Shreyansh-53/EVSE-CP-analyzer/README.md

# EVSE-CP-analyzer
AC EVSE Control Pilot (CP) Signal Analyzer for EV charging using LTspice, analog signal conditioning, and STM32G474 firmware for PWM decoding and state classification.
