Shreyansh-53/EVSE-CP-analyzer/docs/PLC Report.pdf

# STM32 EVSE CP Signal Analyzer

## Signal Flow in CP

In standard AC EV charging, the EVSE and the EV communicate entirely through the Control Pilot (CP) signal, governed by the IEC 61851-1 protocol. The CP signal carries two independent pieces of information:

Voltage Level
+12V / +9V / +6V / +3V

Tells the EVSE: is the EV present, connected, or charging?

PWM Duty Cycle

### 1 kHz · 10% to 96%

Tells the EV: what is the maximum current you may draw?

## Signal Conditioning Circuit

The signal conditioning circuit scales the ±12V CP signal to a 0–3.3V range and provides galvanic isolation (PC817 optocoupler, 5000V rated) between the EVSE mains-referenced PE ground and the MCU signal ground.

1) Duty of Original Signal decides the current limit.
2) Altitude of PWM of Original Signal decides the State of Charging.

## LTSpice Simulation of signal conditioning circuit-

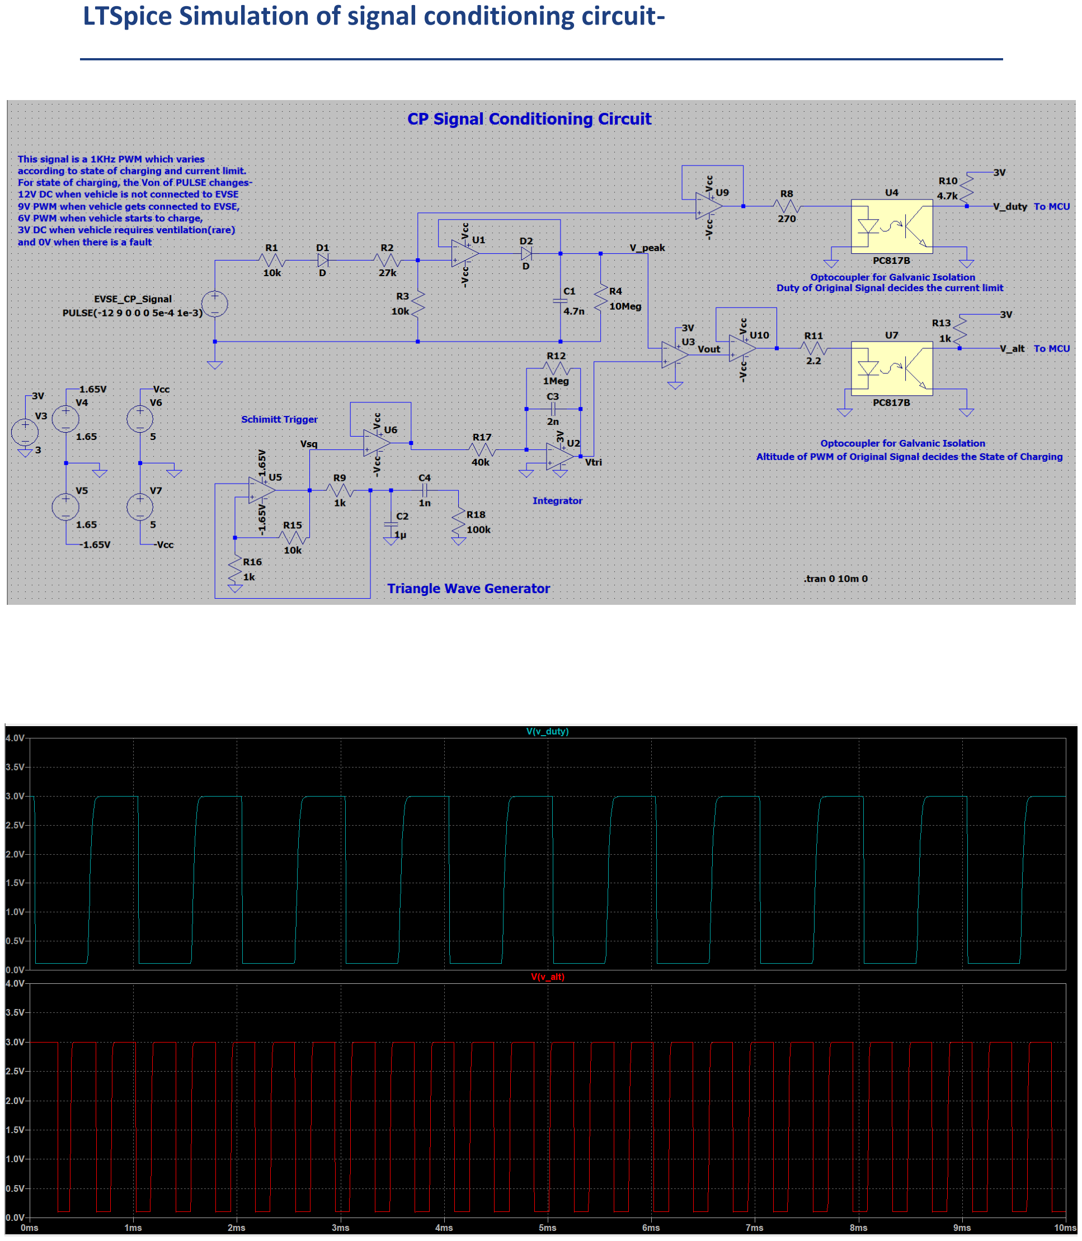
[picture p1: page 2]

## EV Connection States & Coded Logic

State | Description | PWM on PA0? | ADC Threshold (PA1)
A | Standby — No EV connected | No (DC only) | ADC ≥ 2600 mV
B | EV Connected — Ready to charge | Yes (1 kHz) | ADC ≥ 1837 mV
C | Charging — EV drawing current | Yes (1 kHz) | 400 mV ≤ ADC < 1837 mV
D | Charging + Ventilation required | No (DC only) | 400 mV ≤ ADC < 2600 mV
E | Fault — CP shorted or open circuit | No | ADC < 400 mV (no prior PWM)
F | EVSE Internal Fault | No | ADC < 400 mV (PWM was seen before)

## Current Limit Calculation (IEC 61851-1)

Duty Cycle | Max Current | Formula
8% to 85% | 4.8 A to 51.0 A | I = duty × 0.6
85% to 97% | 52.5 A to 82.5 A | I = (duty − 64) × 2.5
< 8% or > 97% | 0 A (Fault zone) | Current = 0 (system stops)
Examples: 25% → 25×0.6 = 15.0A | 50% → 50×0.6 = 30.0A | 90% → (90−64)×2.5 = 65.0A

## Conditioned Signal Waveforms (At STM32 Input)

These waveforms are supplied directly by the function generator to PA0 and PA1, bypassing the conditioning circuit, to verify the firmware before connecting to a real EVSE.

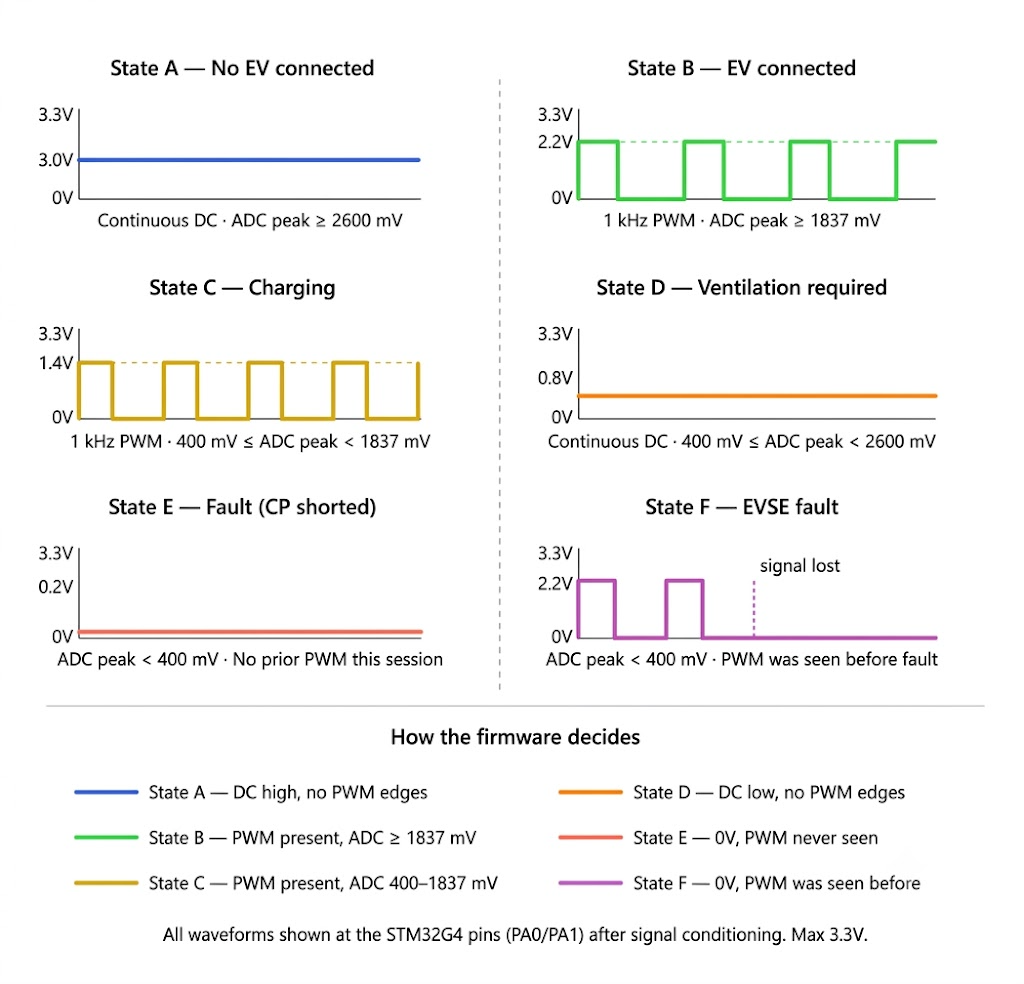
[picture p2: figure]
