Shreyansh-53/EVSE-CP-analyzer/docs/Screenshot 2026-07-09 130957.png

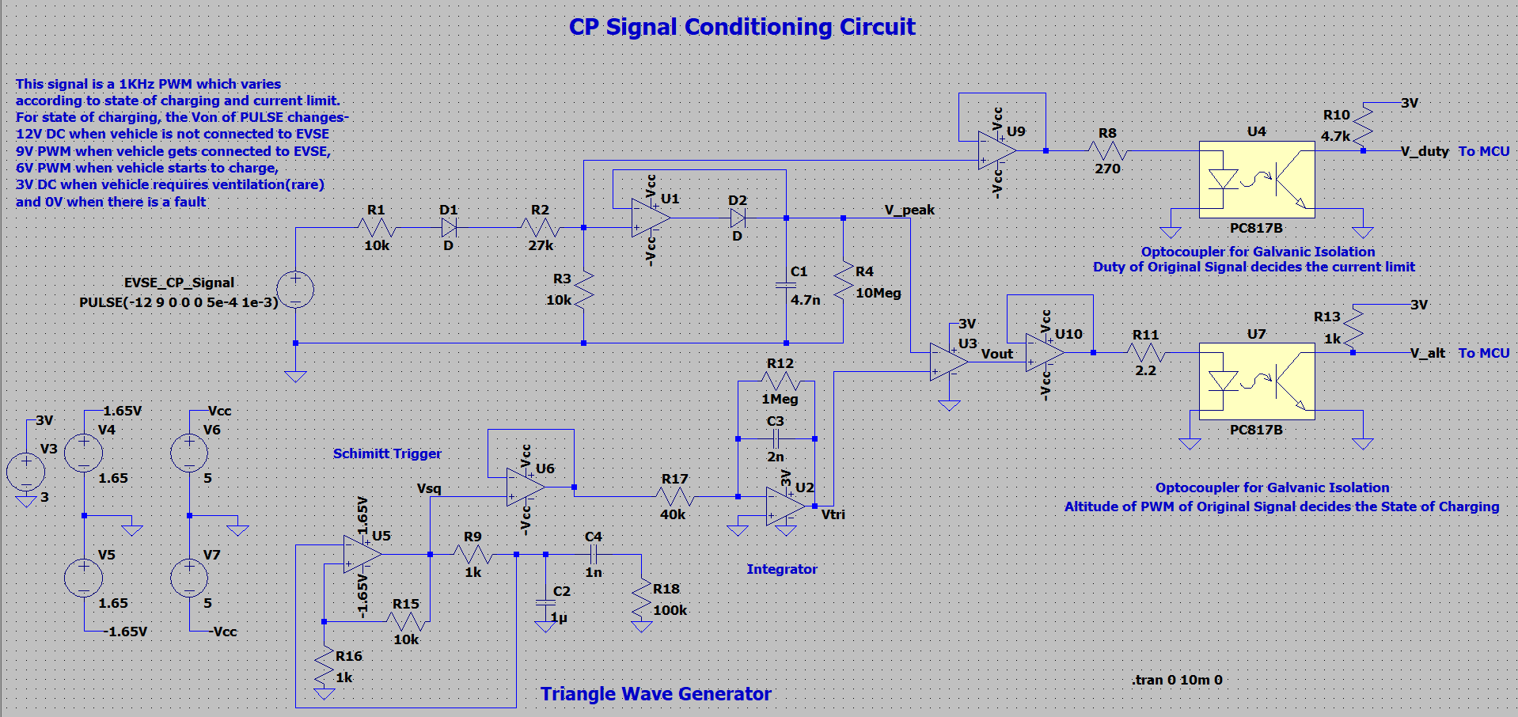
docs/Screenshot 2026-07-09 130957.png
