Shreyansh-53/EVSE-CP-analyzer/docs/Screenshot 2026-07-09 131216.png

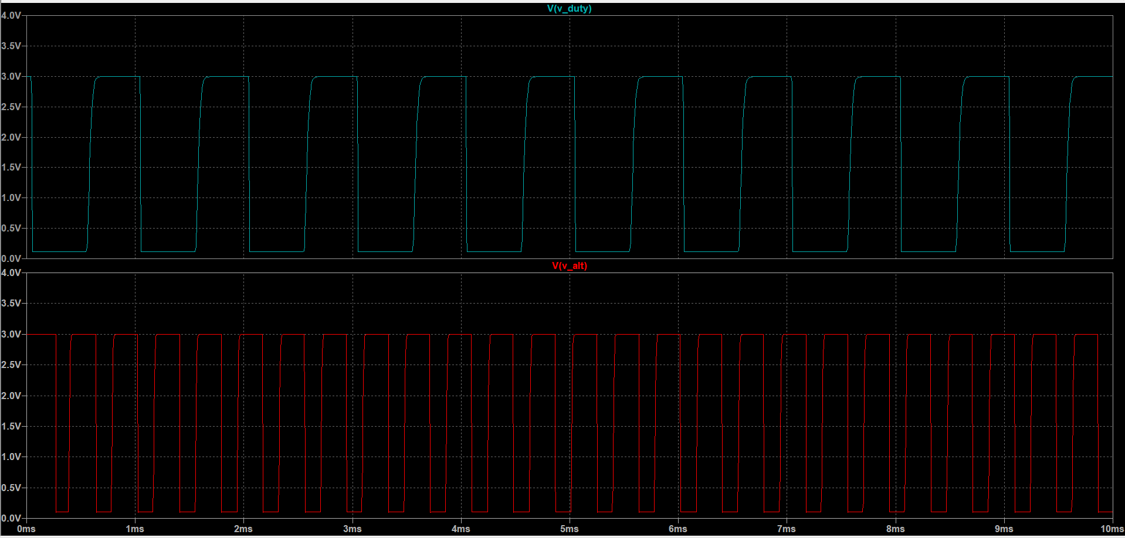
docs/Screenshot 2026-07-09 131216.png
