Shreyansh-53/EVSE-CP-analyzer/hardware/CP signal.asc

C1: cap; 4.7n
C2: cap; 1µ
C3: cap; 2n
C4: cap; 1n
D1: diode
D2: diode
EVSE_CP_Signal: voltage; PULSE(-12 9 0 0 0 5e-4 1e-3)
R1: res; 10k
R2: res; 27k
R3: res; 10k
R4: res; 10Meg
R8: res; 270
R9: res; 1k
R10: res; 4.7k
R11: res; 2.2
R12: res; 1Meg
R13: res; 1k
R15: res; 10k
R16: res; 1k
R17: res; 40k
R18: res; 100k
U1: UniversalOpAmp2
U2: UniversalOpAmp2; Avol=1Meg GBW=10Meg Slew=100Meg
U3: UniversalOpAmp2
U4: PC817B
U5: UniversalOpAmp2
U6: UniversalOpAmp2
U7: PC817B
U9: UniversalOpAmp2
U10: UniversalOpAmp2
V3: voltage; 3
V4: voltage; 1.65
V5: voltage; 1.65
V6: voltage; 5
V7: voltage; 5
Named nets: 0, Vcc, -Vcc, V_peak, Vout, Vtri, 3V, V_alt, V_duty, 1.65V, -1.65V, Vsq
.tran 0 10m 0
Triangle Wave Generator
Schimitt Trigger
Integrator
To MCU
To MCU
Optocoupler for Galvanic Isolation
Optocoupler for Galvanic Isolation
Duty of Original Signal decides the current limit
Altitude of PWM of Original Signal decides the State of Charging
CP Signal Conditioning Circuit
This signal is a 1KHz PWM which varies
according to state of charging and current limit.
For state of charging, the Von of PULSE changes-
12V DC when vehicle is not connected to EVSE
9V PWM when vehicle gets connected to EVSE,
6V PWM when vehicle starts to charge,
3V DC when vehicle requires ventilation(rare)
and 0V when there is a fault
