Shreyansh-53/EVSE-CP-analyzer/firmware/CP_Analyzer/CP_Analyzer.ioc

Mcu.UserName=STM32G474RETx
PA6.Signal=S_TIM3_CH1
PC0.Signal=S_TIM1_CH1
